Minko82/xlerobot-pro/cube-vision/outputs/ik_target.png

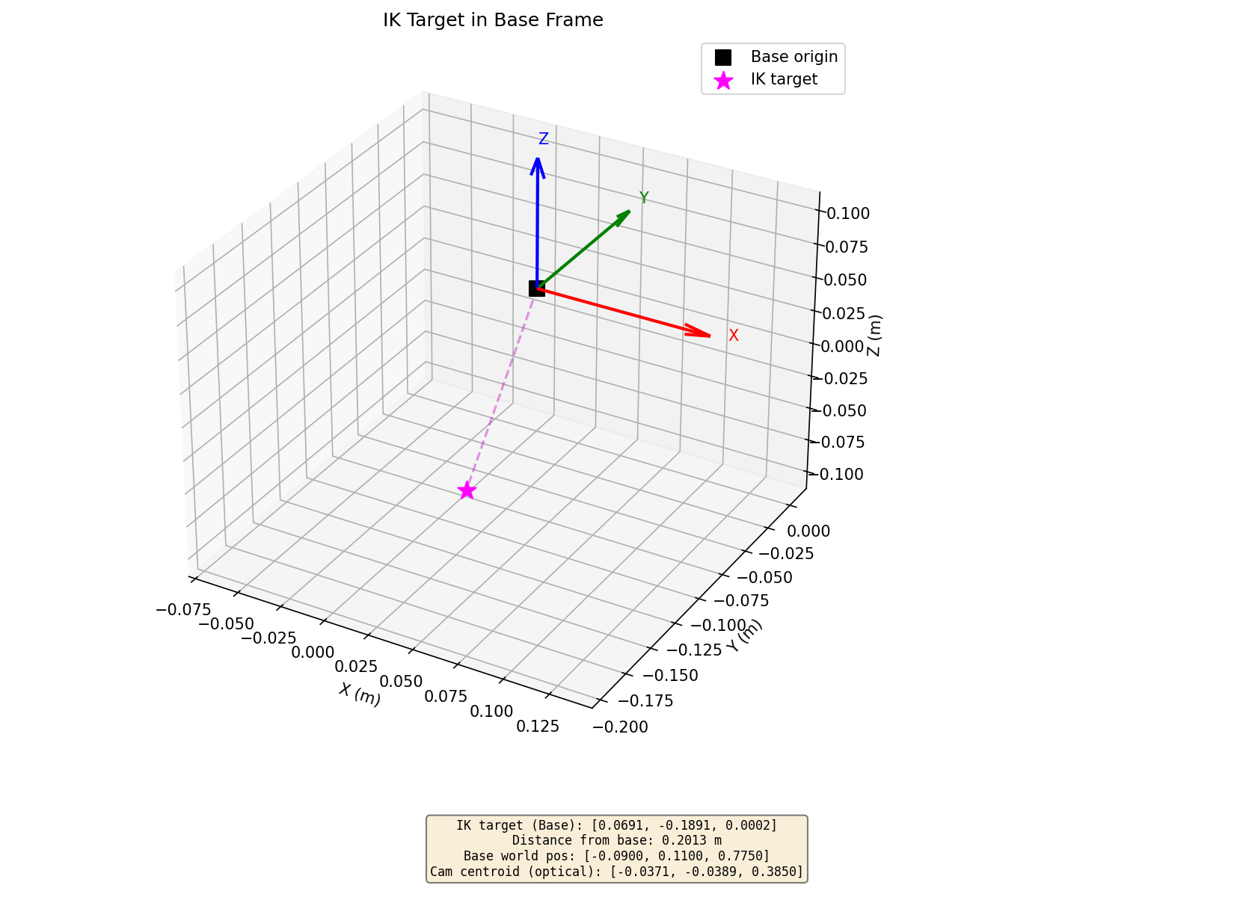
cube-vision/outputs/ik_target.png
