Minko82/xlerobot-pro/cube-vision/outputs/realsense_capture/color.png

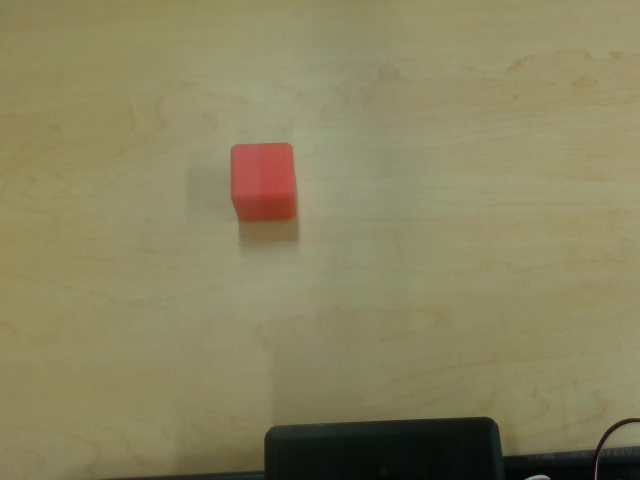
cube-vision/outputs/realsense_capture/color.png
