Minko82/xlerobot-pro/cube-vision/outputs/realsense_capture/color_detect_vis.png

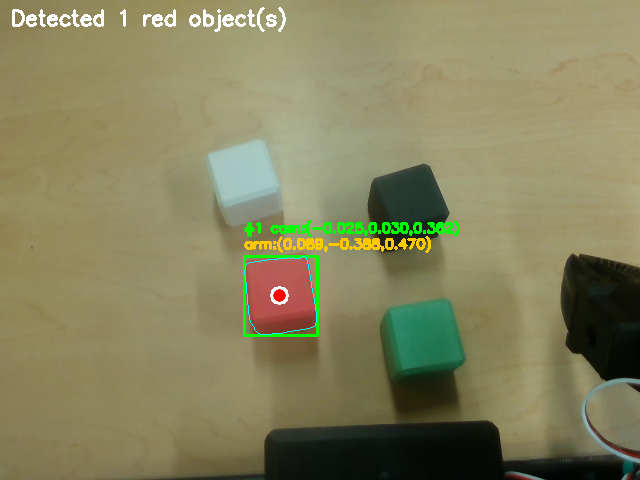
cube-vision/outputs/realsense_capture/color_detect_vis.png
