Minko82/xlerobot-pro/cube-vision/outputs/realsense_capture/depth_16u.png

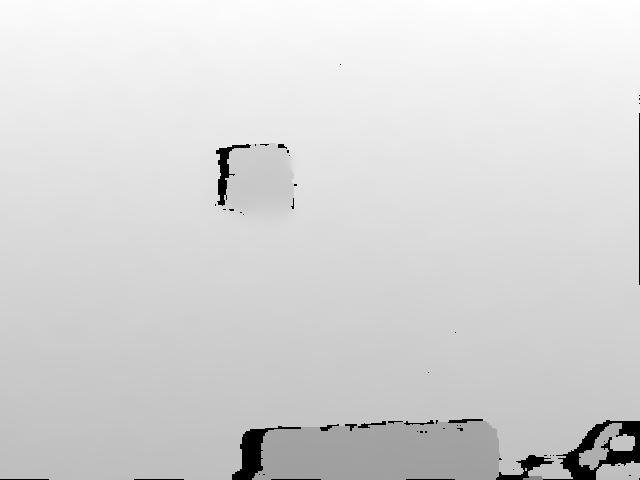
cube-vision/outputs/realsense_capture/depth_16u.png
