Minko82/xlerobot-pro/cube-vision/pincer_transform/outputs/realsense_capture/color.png

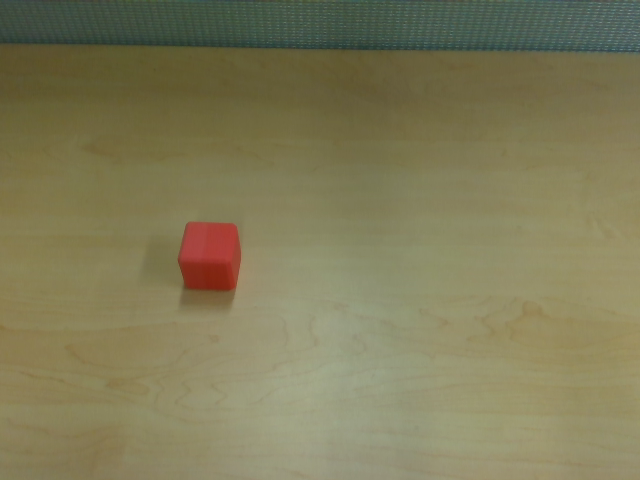
cube-vision/pincer_transform/outputs/realsense_capture/color.png
