Minko82/xlerobot-pro/cube-vision/pincer_transform/outputs/realsense_capture/depth_16u.png

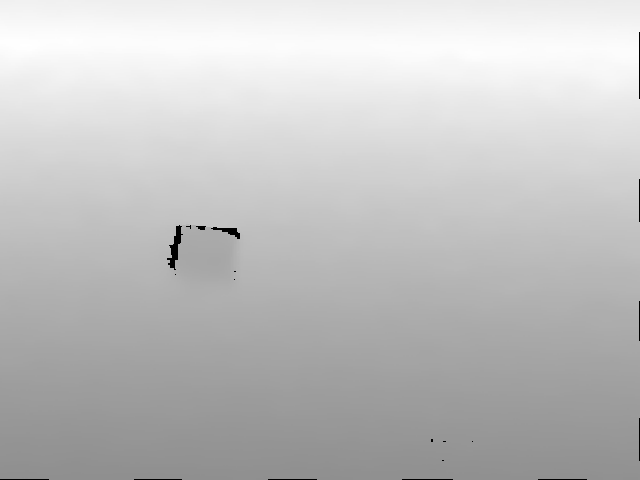
cube-vision/pincer_transform/outputs/realsense_capture/depth_16u.png
