Minko82/xlerobot-pro/hardware/XLeRobot-Pro.3mf

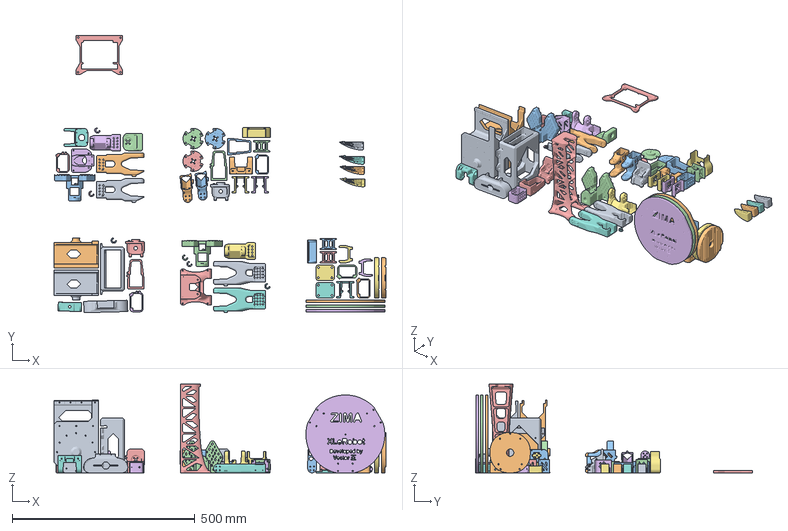
[picture p8: CAD file, 2026-10-27]
hardware/XLeRobot-Pro.3mf
908.2 x 758.7 x 242.5 mm
XLeRobot_0_3_0_1
XLeRobot_0_3_0_2 x 2
XLeRobot_0_3_0_3
XLeRobot_0_3_0_4
XLeRobot_0_3_0_5
XLeRobot_0_3_0_7
XLeRobot_0_3_0_9
XLeRobot_0_3_0_10
XLeRobot_0_3_0_11
XLeRobot_0_3_0_12
XLeRobot_0_3_0_13
XLeRobot_0_3_0_16
XLeRobot_0_3_0_17
XLeRobot_0_3_0_18
XLeRobot_0_3_0_20
XLeRobot_0_3_0_21
XLeRobot_0_3_0_24
XLeRobot_0_3_0_25
XLeRobot_0_3_0_30
XLeRobot_0_3_0_31
XLeRobot_0_3_0_32
XLeRobot_0_3_0_33
XLeRobot_0_3_0_34
XLeRobot_0_3_0_35
XLeRobot_0_3_0_36
XLeRobot_0_3_0_37 (arm, High-Shell) x 2
XLeRobot_0_3_0_38 (arm, High-Shell) x 2
XLeRobot_0_3_0_39 (arm, High-Shell) x 2
XLeRobot_0_3_0_40 (arm, High-Shell) x 2
XLeRobot_0_3_0_41 (arm, High-Shell) x 2
XLeRobot_0_3_0_42 (arm, High-Shell) x 2
XLeRobot_0_3_0_43 (arm, High-Shell) x 2
XLeRobot_0_3_0_44 (arm, High-Shell) x 2
XLeRobot_0_3_0_45 (arm, High-Shell) x 2
XLeRobot_0_3_0_46
XLeRobot_0_3_0_47
XLeRobot_0_3_0_48
XLeRobot_0_3_0_49
XLeRobot_0_3_0_50
XLeRobot_0_3_0_51
Jetson open frame
