Minko82/xlerobot-pro/hardware/XLeRobot040_armbase.step

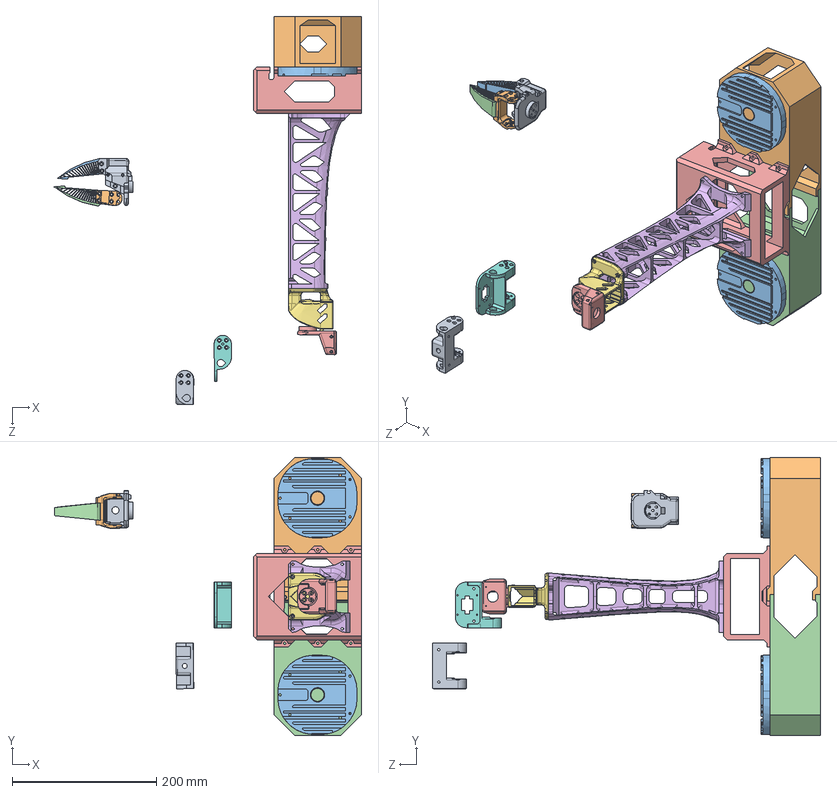
[picture p9: CAD file, 2026-10-11]
hardware/XLeRobot040_armbase.step
426.9 x 386.3 x 538.7 mm
035hand.step
soft_gripper_finger.step
Gimbal_Yaw.step
XLeRobot 0-2-9-3d.step
Gimbal_Base.step
Folder 136
035armbase.step
XLeRobot 0-2-9bas.step
