Minko82/xlerobot-pro/hardware/nvidia-jetson-mounting-frame.stl

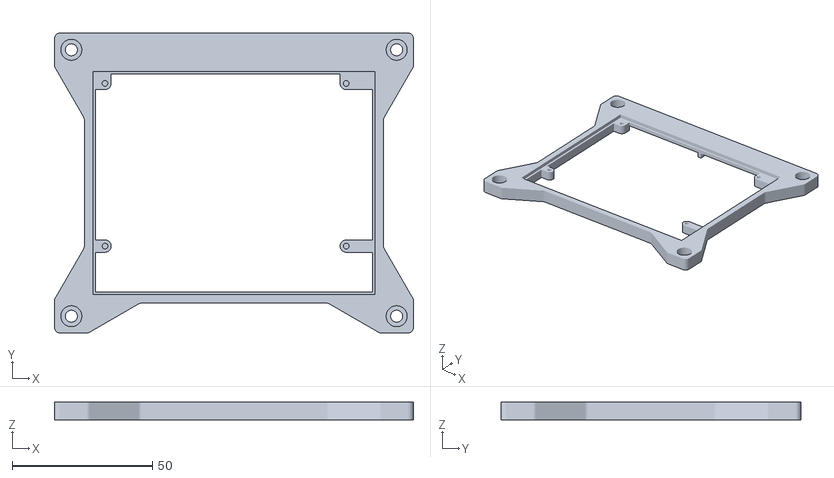
[picture p10: CAD file, 2026-10-11]
hardware/nvidia-jetson-mounting-frame.stl
128.0 x 107.0 x 6.30
