Minko82/xlerobot-pro/(list of files, cad)

Other CAD files:
cube-vision/example_capture/outputs/realsense_capture/vision.ply
