Minko82/xlerobot-pro/examples/precision_test_results.csv

trial | start_x | start_y | start_z | start_pan | target_x | target_y | target_z | target_pan | final_x | final_y | final_z | final_pan | x_error_mm | y_error_mm | z_error_mm | euclidean_error_mm | pan_error_deg
1 | 0.179924 | 0.059685 | 0.000000 | -36.844 | 0.162900 | 0.113100 | 0.000000 | 0.000 | -0.097528 | 0.145064 | 0.000000 | -33.820 | -260.4283 | 31.9638 | 0.0000 | 262.3825 | -33.8195
2 | 0.133913 | 0.084498 | 0.000000 | -37.503 | 0.162900 | 0.113100 | 0.000000 | 0.000 | -0.122219 | 0.116722 | 0.000000 | -34.282 | -285.1193 | 3.6219 | 0.0000 | 285.1423 | -34.2822
3 | 0.173668 | 0.139240 | 0.000000 | 39.840 | 0.162900 | 0.113100 | 0.000000 | 0.000 | -0.096881 | 0.170610 | 0.000000 | -26.995 | -259.7806 | 57.5102 | 0.0000 | 266.0702 | -26.9948
4 | 0.176573 | 0.100096 | 0.000000 | -38.066 | 0.162900 | 0.113100 | 0.000000 | 0.000 | -0.095513 | 0.170905 | 0.000000 | -34.398 | -258.4129 | 57.8045 | 0.0000 | 264.7991 | -34.3979
5 | 0.133247 | 0.110077 | 0.000000 | -21.797 | 0.162900 | 0.113100 | 0.000000 | 0.000 | -0.123035 | 0.114905 | 0.000000 | -34.398 | -285.9349 | 1.8046 | 0.0000 | 285.9406 | -34.3979
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
