Minko82/xlerobot-pro/src/lerobot/robots/xlerobot_2wheels/xlerobot_2wheels_client.py

# Copyright 2024 The HuggingFace Inc. team. All rights reserved.
#
# Licensed under the Apache License, Version 2.0 (the "License");
# you may not use this file except in compliance with the License.
# You may obtain a copy of the License at
#
#     http://www.apache.org/licenses/LICENSE-2.0
#
# Unless required by applicable law or agreed to in writing, software
# distributed under the License is distributed on an "AS IS" BASIS,
# WITHOUT WARRANTIES OR CONDITIONS OF ANY KIND, either express or implied.
# See the License for the specific language governing permissions and
# limitations under the License.

# TODO(aliberts, Steven, Pepijn): use gRPC calls instead of zmq?

import base64
import json
import logging
from functools import cached_property
from typing import Any, Dict, Optional, Tuple

import cv2
import numpy as np
import zmq

from lerobot.utils.errors import DeviceAlreadyConnectedError, DeviceNotConnectedError

from ..robot import Robot
from .config_xlerobot_2wheels import XLerobot2WheelsConfig, XLerobot2WheelsClientConfig


class XLerobot2WheelsClient(Robot):
    config_class = XLerobot2WheelsClientConfig
    name = "xlerobot_2wheels_client"

    def __init__(self, config: XLerobot2WheelsClientConfig):
        super().__init__(config)
        self.config = config
        self.id = config.id
        self.robot_type = config.type

        self.remote_ip = config.remote_ip
        self.port_zmq_cmd = config.port_zmq_cmd
        self.port_zmq_observations = config.port_zmq_observations

        self.teleop_keys = config.teleop_keys

        self.polling_timeout_ms = config.polling_timeout_ms
        self.connect_timeout_s = config.connect_timeout_s

        self.zmq_context = None
        self.zmq_cmd_socket = None
        self.zmq_observation_socket = None

        self.last_frames = {}
        self.last_remote_state = {}

        # Define three speed levels and a current index
        self.speed_levels = [
            {"linear": 0.1, "angular": 30},  # slow
            {"linear": 0.2, "angular": 60},  # medium
            {"linear": 0.3, "angular": 90},  # fast
        ]
        self.speed_index = 0  # Start at slow

        self._is_connected = False
        self.logs = {}

    @cached_property
    def _state_ft(self) -> dict[str, type]:
        return dict.fromkeys(
            (
                "left_arm_shoulder_pan.pos",
                "left_arm_shoulder_lift.pos",
                "left_arm_elbow_flex.pos",
                "left_arm_wrist_flex.pos",
                "left_arm_wrist_roll.pos",
                "left_arm_gripper.pos",
                "right_arm_shoulder_pan.pos",
                "right_arm_shoulder_lift.pos",
                "right_arm_elbow_flex.pos",
                "right_arm_wrist_flex.pos",
                "right_arm_wrist_roll.pos",
                "right_arm_gripper.pos",
                "head_motor_1.pos",
                "head_motor_2.pos",
                "x.vel",
                "theta.vel",  # Only x and theta for differential drive
            ),
            float,
        )
        
    @cached_property
    def _state_order(self) -> tuple[str, ...]:
        return tuple(self._state_ft.keys())

    @cached_property
    def _cameras_ft(self) -> dict[str, tuple[int, int, int]]:
        return {name: (cfg.height, cfg.width, 3) for name, cfg in self.config.cameras.items()}

    @cached_property
    def observation_features(self) -> dict[str, type | tuple]:
        return {**self._state_ft, **self._cameras_ft}

    @cached_property
    def action_features(self) -> dict[str, type]:
        return self._state_ft

    @property
    def is_connected(self) -> bool:
        return self._is_connected

    @property
    def is_calibrated(self) -> bool:
        pass

    def connect(self) -> None:
        """Establishes ZMQ sockets with the remote mobile robot"""

        if self._is_connected:
            raise DeviceAlreadyConnectedError(
                "XLerobot2Wheels Daemon is already connected. Do not run `robot.connect()` twice."
            )

        self.zmq_context = zmq.Context()
        self.zmq_cmd_socket = self.zmq_context.socket(zmq.PUSH)
        zmq_cmd_locator = f"tcp://{self.remote_ip}:{self.port_zmq_cmd}"
        self.zmq_cmd_socket.connect(zmq_cmd_locator)
        self.zmq_cmd_socket.setsockopt(zmq.CONFLATE, 1)

        self.zmq_observation_socket = self.zmq_context.socket(zmq.PULL)
        zmq_observations_locator = f"tcp://{self.remote_ip}:{self.port_zmq_observations}"
        self.zmq_observation_socket.connect(zmq_observations_locator)
        self.zmq_observation_socket.setsockopt(zmq.CONFLATE, 1)

        poller = zmq.Poller()
        poller.register(self.zmq_observation_socket, zmq.POLLIN)
        socks = dict(poller.poll(self.connect_timeout_s * 1000))
        if self.zmq_observation_socket not in socks or socks[self.zmq_observation_socket] != zmq.POLLIN:
            raise DeviceNotConnectedError("Timeout waiting for XLerobot2Wheels Host to connect expired.")

        self._is_connected = True

    def calibrate(self) -> None:
        pass

    def _poll_and_get_latest_message(self) -> Optional[str]:
        """Polls the ZMQ socket for a limited time and returns the latest message string."""
        poller = zmq.Poller()
        poller.register(self.zmq_observation_socket, zmq.POLLIN)

        try:
            socks = dict(poller.poll(self.polling_timeout_ms))
        except zmq.ZMQError as e:
            logging.error(f"ZMQ polling error: {e}")
            return None

        if self.zmq_observation_socket not in socks:
            logging.info("No new data available within timeout.")
            return None

        last_msg = None
        while True:
            try:
                msg = self.zmq_observation_socket.recv_string(zmq.NOBLOCK)
                last_msg = msg
            except zmq.Again:
                break

        if last_msg is None:
            logging.warning("Poller indicated data, but failed to retrieve message.")

        return last_msg

    def _parse_observation_json(self, obs_string: str) -> Optional[Dict[str, Any]]:
        """Parses the JSON observation string."""
        try:
            return json.loads(obs_string)
        except json.JSONDecodeError as e:
            logging.error(f"Error decoding JSON observation: {e}")
            return None

    def _decode_image_from_b64(self, image_b64: str) -> Optional[np.ndarray]:
        """Decodes a base64 encoded image string to an OpenCV image."""
        if not image_b64:
            return None
        try:
            jpg_data = base64.b64decode(image_b64)
            np_arr = np.frombuffer(jpg_data, dtype=np.uint8)
            frame = cv2.imdecode(np_arr, cv2.IMREAD_COLOR)
            if frame is None:
                logging.warning("cv2.imdecode returned None for an image.")
            return frame
        except (TypeError, ValueError) as e:
            logging.error(f"Error decoding base64 image data: {e}")
            return None

    def _remote_state_from_obs(
        self, observation: Dict[str, Any]
    ) -> Tuple[Dict[str, np.ndarray], Dict[str, Any]]:
        """Extracts frames, and state from the parsed observation."""

        flat_state = {key: observation.get(key, 0.0) for key in self._state_order}

        state_vec = np.array([flat_state[key] for key in self._state_order], dtype=np.float32)

        obs_dict: Dict[str, Any] = {**flat_state, "observation.state": state_vec}

        # Decode images
        current_frames: Dict[str, np.ndarray] = {}
        for cam_name, image_b64 in observation.items():
            if cam_name not in self._cameras_ft:
                continue
            frame = self._decode_image_from_b64(image_b64)
            if frame is not None:
                current_frames[cam_name] = frame

        return current_frames, obs_dict

    def _get_data(self) -> Tuple[Dict[str, np.ndarray], Dict[str, Any], Dict[str, Any]]:
        """
        Polls the video socket for the latest observation data.

        Attempts to retrieve and decode the latest message within a short timeout.
        If successful, updates and returns the new frames, speed, and arm state.
        If no new data arrives or decoding fails, returns the last known values.
        """

        # 1. Get the latest message string from the socket
        latest_message_str = self._poll_and_get_latest_message()

        # 2. If no message, return cached data
        if latest_message_str is None:
            return self.last_frames, self.last_remote_state

        # 3. Parse the JSON message
        observation = self._parse_observation_json(latest_message_str)

        # 4. If JSON parsing failed, return cached data
        if observation is None:
            return self.last_frames, self.last_remote_state

        # 5. Process the valid observation data
        try:
            new_frames, new_state = self._remote_state_from_obs(observation)
        except Exception as e:
            logging.error(f"Error processing observation data, serving last observation: {e}")
            return self.last_frames, self.last_remote_state

        self.last_frames = new_frames
        self.last_remote_state = new_state

        return new_frames, new_state

    def get_observation(self) -> dict[str, Any]:
        """
        Capture observations from the remote robot: current follower arm positions,
        present wheel speeds (converted to body-frame velocities: x, theta),
        and a camera frame. Receives over ZMQ, translate to body-frame vel
        """
        if not self._is_connected:
            raise DeviceNotConnectedError("XLerobot2WheelsClient is not connected. You need to run `robot.connect()`.")

        frames, obs_dict = self._get_data()

        # Loop over each configured camera
        for cam_name, frame in frames.items():
            if frame is None:
                logging.warning("Frame is None")
                frame = np.zeros((640, 480, 3), dtype=np.uint8)
            obs_dict[cam_name] = frame

        return obs_dict

    def _from_keyboard_to_base_action(self, pressed_keys: np.ndarray):
        # Speed control
        if self.teleop_keys["speed_up"] in pressed_keys:
            self.speed_index = min(self.speed_index + 1, 2)
        if self.teleop_keys["speed_down"] in pressed_keys:
            self.speed_index = max(self.speed_index - 1, 0)
        speed_setting = self.speed_levels[self.speed_index]
        linear_speed = speed_setting["linear"]  # e.g. 0.1, 0.2, or 0.3
        angular_speed = speed_setting["angular"]  # e.g. 30, 60, or 90

        x_cmd = 0.0  # m/s forward/backward
        theta_cmd = 0.0  # deg/s rotation

        if self.teleop_keys["forward"] in pressed_keys:
            x_cmd += linear_speed
        if self.teleop_keys["backward"] in pressed_keys:
            x_cmd -= linear_speed
        if self.teleop_keys["rotate_left"] in pressed_keys:
            theta_cmd += angular_speed
        if self.teleop_keys["rotate_right"] in pressed_keys:
            theta_cmd -= angular_speed
            
        return {
            "x.vel": x_cmd, 
            "theta.vel": theta_cmd,
        }

    def configure(self):
        pass

    def send_action(self, action: dict[str, Any]) -> dict[str, Any]:
        """Command xlerobot_2wheels to move to a target joint configuration. Translates to motor space + sends over ZMQ

        Args:
            action (np.ndarray): array containing the goal positions for the motors.

        Raises:
            RobotDeviceNotConnectedError: if robot is not connected.

        Returns:
            np.ndarray: the action sent to the motors, potentially clipped.
        """
        if not self._is_connected:
            raise DeviceNotConnectedError(
                "XLerobot2Wheels is not connected. You need to run `robot.connect()`."
            )

        self.zmq_cmd_socket.send_string(json.dumps(action))  # action is in motor space

        # TODO(Steven): Remove the np conversion when it is possible to record a non-numpy array value
        actions = np.array([action.get(k, 0.0) for k in self._state_order], dtype=np.float32)

        action_sent = {key: actions[i] for i, key in enumerate(self._state_order)}
        action_sent["action"] = actions
        return action_sent

    def disconnect(self):
        """Cleans ZMQ comms"""

        if not self._is_connected:
            raise DeviceNotConnectedError(
                "XLerobot2Wheels is not connected. You need to run `robot.connect()` before disconnecting."
            )
        self.zmq_observation_socket.close()
        self.zmq_cmd_socket.close()
        self.zmq_context.term()
        self._is_connected = False
