Minko82/xlerobot-pro/src/lerobot/robots/xlerobot/config_xlerobot.py

# Copyright 2024 The HuggingFace Inc. team. All rights reserved.
#
# Licensed under the Apache License, Version 2.0 (the "License");
# you may not use this file except in compliance with the License.
# You may obtain a copy of the License at
#
#     http://www.apache.org/licenses/LICENSE-2.0
#
# Unless required by applicable law or agreed to in writing, software
# distributed under the License is distributed on an "AS IS" BASIS,
# WITHOUT WARRANTIES OR CONDITIONS OF ANY KIND, either express or implied.
# See the License for the specific language governing permissions and
# limitations under the License.

from dataclasses import dataclass, field

from lerobot.cameras.configs import CameraConfig, Cv2Rotation, ColorMode
from lerobot.cameras.opencv.configuration_opencv import OpenCVCameraConfig
from lerobot.cameras.realsense import RealSenseCamera, RealSenseCameraConfig

from ..config import RobotConfig


def xlerobot_cameras_config() -> dict[str, CameraConfig]:
    return {
        # "left_wrist": OpenCVCameraConfig(
        #     index_or_path="/dev/video0", fps=30, width=640, height=480, rotation=Cv2Rotation.NO_ROTATION
        # ),

        # "right_wrist": OpenCVCameraConfig(
        #     index_or_path="/dev/video2", fps=30, width=640, height=480, rotation=Cv2Rotation.NO_ROTATION
        # ),  

        # "head(RGDB)": OpenCVCameraConfig(
        #     index_or_path="/dev/video2", fps=30, width=640, height=480, rotation=Cv2Rotation.NO_ROTATION
        # ),                     
        
        # "head": RealSenseCameraConfig(
        #     serial_number_or_name="125322060037",  # Replace with camera SN
        #     fps=30,
        #     width=1280,
        #     height=720,
        #     color_mode=ColorMode.BGR, # Request BGR output
        #     rotation=Cv2Rotation.NO_ROTATION,
        #     use_depth=True
        # ),
    }


@RobotConfig.register_subclass("xlerobot")
@dataclass
class XLerobotConfig(RobotConfig):
    """
    OLD WIRING DESIGN
    Bus 1 (port1): Motors 1-6 = left arm, Motors 7-8 = head
    Bus 2 (port2): Motors 1-6 = right arm, Motors 7-9 = base wheels
    """

    port1: str = "/dev/xle_right"  # Bus 1: left arm (1-6) + head (7-8)
    port2: str = "/dev/xle_left"   # Bus 2: right arm (1-6) + base wheels (7-9)
    disable_torque_on_disconnect: bool = True

    # `max_relative_target` limits the magnitude of the relative positional target vector for safety purposes.
    # Set this to a positive scalar to have the same value for all motors, or a list that is the same length as
    # the number of motors in your follower arms.
    max_relative_target: int | None = None

    cameras: dict[str, CameraConfig] = field(default_factory=xlerobot_cameras_config)

    # Set to `True` for backward compatibility with previous policies/dataset
    use_degrees: bool = False

    teleop_keys: dict[str, str] = field(
        default_factory=lambda: {
            # Movement
            "forward": "i",
            "backward": "k",
            "left": "j",
            "right": "l",
            "rotate_left": "u",
            "rotate_right": "o",
            # Speed control
            "speed_up": "n",
            "speed_down": "m",
            # quit teleop
            "quit": "b",
        }
    )



@dataclass
class XLerobotHostConfig:
    # Network Configuration
    port_zmq_cmd: int = 5555
    port_zmq_observations: int = 5556

    # Duration of the application
    connection_time_s: int = 3600

    # Watchdog: stop the robot if no command is received for over 0.5 seconds.
    watchdog_timeout_ms: int = 500

    # If robot jitters decrease the frequency and monitor cpu load with `top` in cmd
    max_loop_freq_hz: int = 30

@RobotConfig.register_subclass("xlerobot_client")
@dataclass
class XLerobotClientConfig(RobotConfig):
    # Network Configuration
    remote_ip: str
    port_zmq_cmd: int = 5555
    port_zmq_observations: int = 5556

    teleop_keys: dict[str, str] = field(
        default_factory=lambda: {
            # Movement
            "forward": "i",
            "backward": "k",
            "left": "j",
            "right": "l",
            "rotate_left": "u",
            "rotate_right": "o",
            # Speed control
            "speed_up": "n",
            "speed_down": "m",
            # quit teleop
            "quit": "b",
        }
    )

    cameras: dict[str, CameraConfig] = field(default_factory=xlerobot_cameras_config)

    polling_timeout_ms: int = 15
    connect_timeout_s: int = 5


@RobotConfig.register_subclass("xlerobot_new_wiring")
@dataclass
class XLerobotNewWiringConfig(RobotConfig):
    """
    NEW WIRING DESIGN
    Bus 1 (port1): Motors 1-6 = left arm, Motors 7-12 = right arm
    Bus 2 (port2): Motors 1-2 = head, Motors 3-5 = base wheels
    """

    port1: str = "/dev/xle_arms"   # Bus 1: left arm (1-6) + right arm (7-12)
    port2: str = "/dev/xle_head"   # Bus 2: head (1-2) + base wheels (3-5)
    disable_torque_on_disconnect: bool = True

    max_relative_target: int | None = None

    cameras: dict[str, CameraConfig] = field(default_factory=xlerobot_cameras_config)

    use_degrees: bool = False

    teleop_keys: dict[str, str] = field(
        default_factory=lambda: {
            # Movement
            "forward": "i",
            "backward": "k",
            "left": "j",
            "right": "l",
            "rotate_left": "u",
            "rotate_right": "o",
            # Speed control
            "speed_up": "n",
            "speed_down": "m",
            # quit teleop
            "quit": "b",
        }
    )
