Minko82/xlerobot-pro/src/lerobot/teleoperators/xlerobot_vr/vr_monitor.py

#!/usr/bin/env python3
"""
VR Monitor - Independent VR control information monitoring script
Can call XLeVR's VR functionality from other folders and read/print VR control information
"""

import asyncio
import contextlib
import http.server
import os
import socket
import ssl
import sys
import threading

# Set the absolute path to the xlevr folder
XLEVR_PATH = "/home/cics/Desktop/codes/projects/XLeRobot/XLeVR"


def setup_xlevr_environment():
    """Setup xlevr environment"""
    # Add xlevr path to Python path
    if XLEVR_PATH not in sys.path:
        sys.path.insert(0, XLEVR_PATH)

    # Set working directory
    os.chdir(XLEVR_PATH)

    # Set environment variables
    os.environ["PYTHONPATH"] = f"{XLEVR_PATH}:{os.environ.get('PYTHONPATH', '')}"


def get_local_ip():
    """Get the local IP address of this machine."""
    try:
        # Connect to a remote address to determine the local IP
        with socket.socket(socket.AF_INET, socket.SOCK_DGRAM) as s:
            s.connect(("8.8.8.8", 80))
            return s.getsockname()[0]
    except Exception:
        try:
            # Fallback: get hostname IP
            return socket.gethostbyname(socket.gethostname())
        except Exception:
            # Final fallback
            return "localhost"


def import_xlevr_modules():
    """Import xlevr modules"""
    try:
        from xlevr.config import XLeVRConfig
        from xlevr.inputs.base import ControlGoal, ControlMode
        from xlevr.inputs.vr_ws_server import VRWebSocketServer

        return XLeVRConfig, VRWebSocketServer, ControlGoal, ControlMode
    except ImportError as e:
        print(f"Error importing xlevr modules: {e}")
        print(f"Make sure XLEVR_PATH is correct: {XLEVR_PATH}")
        return None, None, None, None


class SimpleAPIHandler(http.server.BaseHTTPRequestHandler):
    """Simplified HTTP request handler, only provides basic web services"""

    def end_headers(self):
        """Add CORS headers to all responses."""
        self.send_header("Access-Control-Allow-Origin", "*")
        self.send_header("Access-Control-Allow-Methods", "GET, POST, OPTIONS")
        self.send_header("Access-Control-Allow-Headers", "Content-Type")
        with contextlib.suppress(BrokenPipeError, ConnectionResetError, ConnectionAbortedError, ssl.SSLError):
            super().end_headers()

    def do_OPTIONS(self):
        """Handle preflight CORS requests."""
        self.send_response(200)
        self.end_headers()

    def log_message(self, format, *args):
        """Override to reduce HTTP request logging noise."""
        pass  # Disable default HTTP logging

    def do_GET(self):
        """Handle GET requests."""
        if self.path == "/" or self.path == "/index.html":
            # Serve main page from web-ui directory
            self.serve_file("web-ui/index.html", "text/html")
        elif self.path.endswith(".css"):
            # Serve CSS files from web-ui directory
            self.serve_file(f"web-ui{self.path}", "text/css")
        elif self.path.endswith(".js"):
            # Serve JS files from web-ui directory
            self.serve_file(f"web-ui{self.path}", "application/javascript")
        elif self.path.endswith(".ico"):
            self.serve_file(self.path[1:], "image/x-icon")
        elif self.path.endswith((".jpg", ".jpeg", ".png", ".gif")):
            # Serve image files from web-ui directory
            content_type = (
                "image/jpeg"
                if self.path.endswith((".jpg", ".jpeg"))
                else "image/png"
                if self.path.endswith(".png")
                else "image/gif"
            )
            self.serve_file(f"web-ui{self.path}", content_type)
        else:
            self.send_error(404, "Not found")

    def serve_file(self, filename, content_type):
        """Serve a file with the given content type."""
        try:
            # Get the web root path from the server
            web_root = getattr(self.server, "web_root_path", XLEVR_PATH)
            file_path = os.path.join(web_root, filename)

            if os.path.exists(file_path):
                with open(file_path, "rb") as f:
                    content = f.read()

                self.send_response(200)
                self.send_header("Content-Type", content_type)
                self.end_headers()
                self.wfile.write(content)
            else:
                self.send_error(404, f"File not found: {filename}")
        except Exception as e:
            print(f"Error serving file {filename}: {e}")
            self.send_error(500, "Internal server error")


class SimpleHTTPSServer:
    """Simplified HTTPS server for providing web interface"""

    def __init__(self, config):
        self.config = config
        self.httpd = None
        self.server_thread = None
        self.web_root_path = XLEVR_PATH

    async def start(self):
        """Start the HTTPS server."""
        try:
            # Create server
            self.httpd = http.server.HTTPServer(
                (self.config.host_ip, self.config.https_port), SimpleAPIHandler
            )

            # Set web root path for file serving
            self.httpd.web_root_path = self.web_root_path

            # Setup SSL
            context = ssl.SSLContext(ssl.PROTOCOL_TLS_SERVER)
            context.load_cert_chain("cert.pem", "key.pem")
            self.httpd.socket = context.wrap_socket(self.httpd.socket, server_side=True)

            # Start server in a separate thread
            self.server_thread = threading.Thread(target=self.httpd.serve_forever, daemon=True)
            self.server_thread.start()

            print(f"🌐 HTTPS server started on {self.config.host_ip}:{self.config.https_port}")

        except Exception as e:
            print(f"❌ Failed to start HTTPS server: {e}")
            raise

    async def stop(self):
        """Stop the HTTPS server."""
        if self.httpd:
            self.httpd.shutdown()
            if self.server_thread:
                self.server_thread.join(timeout=5)
            print("🌐 HTTPS server stopped")


class VRMonitor:
    """VR control information monitor"""

    def __init__(self):
        self.config = None
        self.vr_server = None
        self.https_server = None
        self.is_running = False
        self.latest_goal = None  # Store the latest goal
        self.left_goal = None  # Store left and right controller goals separately
        self.right_goal = None
        self.headset_goal = None  # Add headset goal
        self._goal_lock = threading.Lock()  # Add thread lock

    def initialize(self):
        """Initialize VR monitor"""
        print("🔧 Initializing XLeVR Monitor...")

        # Setup environment
        setup_xlevr_environment()

        # Import modules
        XLeVRConfig, VRWebSocketServer, ControlGoal, ControlMode = import_xlevr_modules()  # noqa: N806
        if XLeVRConfig is None:
            print("❌ Failed to import xlevr modules")
            return False

        # Create configuration
        self.config = XLeVRConfig()
        self.config.enable_vr = True
        self.config.enable_keyboard = False
        self.config.enable_https = True  # Enable HTTPS server, VR requires web interface

        # Create command queue
        self.command_queue = asyncio.Queue()

        # Create VR server (print-only mode)
        try:
            self.vr_server = VRWebSocketServer(
                command_queue=self.command_queue,
                config=self.config,
                print_only=False,  # Changed to False to send data to queue
            )
        except Exception as e:
            print(f"❌ Failed to create VR WebSocket server: {e}")
            return False

        # Create HTTPS server
        try:
            self.https_server = SimpleHTTPSServer(self.config)
        except Exception as e:
            print(f"❌ Failed to create HTTPS server: {e}")
            return False

        print("✅ XLeVR Monitor initialized successfully")

        return True

    async def start_monitoring(self):
        """Start monitoring VR control information"""
        print("🚀 Starting VR Monitor...")

        if not self.initialize():
            print("❌ Failed to initialize VR monitor")
            return

        try:
            # Start HTTPS server
            await self.https_server.start()

            # Start VR server
            await self.vr_server.start()

            self.is_running = True
            print("✅ VR Monitor is now running")

            # Display connection information (comparing against 0.0.0.0, not binding to it)
            host_display = get_local_ip() if self.config.host_ip == "0.0.0.0" else self.config.host_ip  # nosec B104
            print("📱 Open your VR headset browser and navigate to:")
            print(f"   https://{host_display}:{self.config.https_port}")
            print("🎯 Press Ctrl+C to stop monitoring")
            print()

            # Monitor command queue
            await self.monitor_commands()

        except KeyboardInterrupt:
            print("\n⏹️  Stopping VR monitor...")
        except Exception as e:
            print(f"❌ Error in VR monitor: {e}")
            import traceback

            print(f"Traceback: {traceback.format_exc()}")
        finally:
            await self.stop_monitoring()

    async def monitor_commands(self):
        """Monitor commands from VR controllers"""
        print("📊 Monitoring VR control commands...")

        while self.is_running:
            try:
                # Wait for command with 1-second timeout
                goal = await asyncio.wait_for(self.command_queue.get(), timeout=1.0)

                # Save goal by arm type
                with self._goal_lock:
                    if goal.arm == "left":
                        self.left_goal = goal
                    elif goal.arm == "right":
                        self.right_goal = goal
                    elif goal.arm == "headset":  # Add headset data processing
                        self.headset_goal = goal

                    # Maintain backward compatibility, save latest goal
                    self.latest_goal = goal

            except asyncio.TimeoutError:
                # Timeout, continue loop
                continue
            except Exception as e:
                print(f"❌ Error processing command: {e}")
                import traceback

                print(f"Traceback: {traceback.format_exc()}")

    def print_control_goal(self, goal):
        """Print control goal information"""
        print("\n🎮 Control Goal Received:")
        print(f"   Timestamp: {asyncio.get_event_loop().time():.3f}")
        print(f"   Arm: {goal.arm}")
        print(f"   Mode: {goal.mode}")

        if goal.target_position is not None:
            if isinstance(goal.target_position, (list, tuple)):
                pos = goal.target_position
                print(f"   Target Position: [{pos[0]:.3f}, {pos[1]:.3f}, {pos[2]:.3f}]")
            else:
                print(f"   Target Position: {goal.target_position}")

        if goal.wrist_roll_deg is not None:
            print(f"   Wrist Roll: {goal.wrist_roll_deg:.1f}°")

        if goal.wrist_flex_deg is not None:
            print(f"   Wrist Flex: {goal.wrist_flex_deg:.1f}°")

        if goal.gripper_closed is not None:
            print(f"   Gripper: {'CLOSED' if goal.gripper_closed else 'OPEN'}")

        if goal.metadata:
            print(f"   Metadata: {goal.metadata}")

        print("-" * 30)

    def get_latest_goal_nowait(self, arm=None):
        """Return the latest VR control goal if available, else None.

        Args:
            arm: If specified ("left" or "right"), return that arm's goal.
                 If None, return a dict containing both left and right goals.
        """
        with self._goal_lock:
            if arm == "left":
                return self.left_goal
            elif arm == "right":
                return self.right_goal
            elif arm == "headset":  # Add headset data retrieval
                return self.headset_goal
            else:
                # Return dictionary containing both left and right controllers
                dual_goals = {
                    "left": self.left_goal,
                    "right": self.right_goal,
                    "headset": self.headset_goal,  # Add headset data
                    "has_left": self.left_goal is not None,
                    "has_right": self.right_goal is not None,
                    "has_headset": self.headset_goal is not None,  # Add headset status
                }

                return dual_goals

    def get_left_goal_nowait(self):
        """Return the latest left arm goal if available, else None."""
        return self.get_latest_goal_nowait("left")

    def get_right_goal_nowait(self):
        """Return the latest right arm goal if available, else None."""
        return self.get_latest_goal_nowait("right")

    async def stop_monitoring(self):
        """Stop monitoring"""
        self.is_running = False

        if self.vr_server:
            await self.vr_server.stop()

        if self.https_server:
            await self.https_server.stop()

        print("✅ VR Monitor stopped")


def main():
    """Main function"""
    print("🎮 XLeVR Monitor - XLeVR VR Control Information Monitor")
    print("=" * 60)

    # Check XLeVR path
    if not os.path.exists(XLEVR_PATH):
        print(f"❌ XLeVR path does not exist: {XLEVR_PATH}")
        print("Please update XLEVR_PATH in the script")
        return

    # Create monitor
    monitor = VRMonitor()

    # Run monitoring
    try:
        asyncio.run(monitor.start_monitoring())
    except KeyboardInterrupt:
        print("\n👋 XLeVR Monitor stopped by user")
    except Exception as e:
        print(f"❌ Unexpected error: {e}")


if __name__ == "__main__":
    main()
