Minko82/xlerobot-pro/examples/5_xlerobot_teleop_xbox_new_wiring.py

# =============================================================================
# NEW WIRING DESIGN
# Bus 1 (port1 = /dev/xle_arms): Motors 1-6 = left arm, Motors 7-12 = right arm
# Bus 2 (port2 = /dev/xle_head): Motors 1-2 = head, Motors 3-5 = base wheels
# =============================================================================

# To Run the teleop:
'''
python examples/5_xlerobot_teleop_xbox_new_wiring.py
'''

import sys
import os
# Ensure xle-robot/src is first on the path so the local lerobot package is used
sys.path.insert(0, os.path.join(os.path.dirname(os.path.abspath(__file__)), '..', 'src'))

import time
import numpy as np
import math
import pygame

from lerobot.robots.xlerobot import XLerobotNewWiringConfig
from lerobot.robots.xlerobot.xlerobot_new_wiring import XLerobotNewWiring
from lerobot.utils.visualization_utils import init_rerun, log_rerun_data
from lerobot.model.SO101Robot import SO101Kinematics

# Keymaps (semantic action: controller mapping) - Intuitive human control
LEFT_KEYMAP = {
    # Left stick controls left arm XY (when not pressed)
    'x+': 'left_stick_up', 'x-': 'left_stick_down',
    'y+': 'left_stick_right', 'y-': 'left_stick_left',
    # Left stick pressed controls left arm shoulder_pan
    'shoulder_pan+': 'left_stick_pressed_right', 'shoulder_pan-': 'left_stick_pressed_left',
    # LB pressed controls left arm pitch and wrist_roll
    'pitch+': 'lb_up', 'pitch-': 'lb_down',
    'wrist_roll+': 'lb_right', 'wrist_roll-': 'lb_left',
    # Left trigger controls left gripper
    'gripper+': 'left_trigger',
    # Head motors
    "head_motor_1+": 'x', "head_motor_1-": 'b',
    "head_motor_2+": 'a', "head_motor_2-": 'y',
}
RIGHT_KEYMAP = {
    # Right stick controls right arm XY (when not pressed)
    'x+': 'right_stick_up', 'x-': 'right_stick_down',
    'y+': 'right_stick_right', 'y-': 'right_stick_left',
    # Right stick pressed controls right arm shoulder_pan
    'shoulder_pan+': 'right_stick_pressed_right', 'shoulder_pan-': 'right_stick_pressed_left',
    # RB pressed controls right arm pitch and wrist_roll
    'pitch+': 'rb_up', 'pitch-': 'rb_down',
    'wrist_roll+': 'rb_right', 'wrist_roll-': 'rb_left',
    # Right trigger controls right gripper
    'gripper+': 'right_trigger',
}

# Base control keymap - Only forward/backward and rotate left/right
BASE_KEYMAP = {
    'forward': 'dpad_down', 'backward': 'dpad_up',
    'rotate_left': 'dpad_left', 'rotate_right': 'dpad_right',
}

# Global reset key for all components
RESET_KEY = 'back'

LEFT_JOINT_MAP = {
    "shoulder_pan": "left_arm_shoulder_pan",
    "shoulder_lift": "left_arm_shoulder_lift",
    "elbow_flex": "left_arm_elbow_flex",
    "wrist_flex": "left_arm_wrist_flex",
    "wrist_roll": "left_arm_wrist_roll",
    "gripper": "left_arm_gripper",
}
RIGHT_JOINT_MAP = {
    "shoulder_pan": "right_arm_shoulder_pan",
    "shoulder_lift": "right_arm_shoulder_lift",
    "elbow_flex": "right_arm_elbow_flex",
    "wrist_flex": "right_arm_wrist_flex",
    "wrist_roll": "right_arm_wrist_roll",
    "gripper": "right_arm_gripper",
}

HEAD_MOTOR_MAP = {
    "head_motor_1": "head_motor_1",
    "head_motor_2": "head_motor_2",
}

class SimpleHeadControl:
    def __init__(self, initial_obs, kp=1):
        self.kp = kp
        self.degree_step = 1
        # Initialize head motor positions
        self.target_positions = {
            "head_motor_1": initial_obs.get("head_motor_1.pos", 0.0),
            "head_motor_2": initial_obs.get("head_motor_2.pos", 0.0),
        }
        self.zero_pos = {"head_motor_1": 0.0, "head_motor_2": 0.0}

    def move_to_initial_position(self, robot, initial_obs):
        print("[HEAD] Moving to Initial Position for safe exit...")
        self.target_positions = {
            "head_motor_1": initial_obs.get("head_motor_1.pos", 0.0),
            "head_motor_2": initial_obs.get("head_motor_2.pos", 0.0),
        }
        action = self.p_control_action(robot)
        robot.send_action(action)

    def move_to_zero_position(self, robot):
        self.target_positions = self.zero_pos.copy()
        action = self.p_control_action(robot)
        robot.send_action(action)

    def handle_keys(self, key_state):
        if key_state.get('head_motor_1+'):
            self.target_positions["head_motor_1"] += self.degree_step
            print(f"[HEAD] head_motor_1: {self.target_positions['head_motor_1']}")
        if key_state.get('head_motor_1-'):
            self.target_positions["head_motor_1"] -= self.degree_step
            print(f"[HEAD] head_motor_1: {self.target_positions['head_motor_1']}")
        if key_state.get('head_motor_2+'):
            self.target_positions["head_motor_2"] += self.degree_step
            print(f"[HEAD] head_motor_2: {self.target_positions['head_motor_2']}")
        if key_state.get('head_motor_2-'):
            self.target_positions["head_motor_2"] -= self.degree_step
            print(f"[HEAD] head_motor_2: {self.target_positions['head_motor_2']}")

    def p_control_action(self, robot):
        obs = robot.get_observation()
        action = {}
        for motor in self.target_positions:
            current = obs.get(f"{HEAD_MOTOR_MAP[motor]}.pos", 0.0)
            error = self.target_positions[motor] - current
            control = self.kp * error
            action[f"{HEAD_MOTOR_MAP[motor]}.pos"] = current + control
        return action

class SimpleTeleopArm:
    def __init__(self, kinematics, joint_map, initial_obs, prefix="left", kp=1):
        self.kinematics = kinematics
        self.joint_map = joint_map
        self.prefix = prefix  # To distinguish left and right arm
        self.kp = kp
        # Initial joint positions
        self.joint_positions = {
            "shoulder_pan": initial_obs[f"{prefix}_arm_shoulder_pan.pos"],
            "shoulder_lift": initial_obs[f"{prefix}_arm_shoulder_lift.pos"],
            "elbow_flex": initial_obs[f"{prefix}_arm_elbow_flex.pos"],
            "wrist_flex": initial_obs[f"{prefix}_arm_wrist_flex.pos"],
            "wrist_roll": initial_obs[f"{prefix}_arm_wrist_roll.pos"],
            "gripper": initial_obs[f"{prefix}_arm_gripper.pos"],
        }
        # Set initial x/y to fixed values
        self.current_x = 0.1629
        self.current_y = 0.1131
        self.pitch = 0.0
        # Set the degree step and xy step
        self.degree_step = 2
        self.xy_step = 0.005
        # Set target positions to zero for P control
        self.target_positions = {
            "shoulder_pan": 0.0,
            "shoulder_lift": 0.0,
            "elbow_flex": 0.0,
            "wrist_flex": 0.0,
            "wrist_roll": 0.0,
            "gripper": 0.0,
        }
        self.zero_pos = {
            'shoulder_pan': 0.0,
            'shoulder_lift': 0.0,
            'elbow_flex': 0.0,
            'wrist_flex': 0.0,
            'wrist_roll': 0.0,
            'gripper': 0.0
        }

    def move_to_initial_position(self, robot, initial_obs):
        print(f"[{self.prefix}] Moving to Initial Position for safe exit...")
        self.target_positions = {
            "shoulder_pan": initial_obs[f"{self.prefix}_arm_shoulder_pan.pos"],
            "shoulder_lift": initial_obs[f"{self.prefix}_arm_shoulder_lift.pos"],
            "elbow_flex": initial_obs[f"{self.prefix}_arm_elbow_flex.pos"],
            "wrist_flex": initial_obs[f"{self.prefix}_arm_wrist_flex.pos"],
            "wrist_roll": initial_obs[f"{self.prefix}_arm_wrist_roll.pos"],
            "gripper": initial_obs[f"{self.prefix}_arm_gripper.pos"],
        }
        action = self.p_control_action(robot)
        robot.send_action(action)

    def move_to_zero_position(self, robot):
        print(f"[{self.prefix}] Moving to Zero Position: {self.zero_pos} ......")
        self.target_positions = self.zero_pos.copy()

        # Reset kinematic variables to their initial state
        self.current_x = 0.1629
        self.current_y = 0.1131
        self.pitch = 0.0

        # Don't let handle_keys recalculate wrist_flex - set it explicitly
        self.target_positions["wrist_flex"] = 0.0

        action = self.p_control_action(robot)
        robot.send_action(action)

    def handle_keys(self, key_state):
        # Joint increments
        if key_state.get('shoulder_pan+'):
            self.target_positions["shoulder_pan"] += self.degree_step
            print(f"[{self.prefix}] shoulder_pan: {self.target_positions['shoulder_pan']}")
        if key_state.get('shoulder_pan-'):
            self.target_positions["shoulder_pan"] -= self.degree_step
            print(f"[{self.prefix}] shoulder_pan: {self.target_positions['shoulder_pan']}")
        if key_state.get('wrist_roll+'):
            self.target_positions["wrist_roll"] += self.degree_step
            print(f"[{self.prefix}] wrist_roll: {self.target_positions['wrist_roll']}")
        if key_state.get('wrist_roll-'):
            self.target_positions["wrist_roll"] -= self.degree_step
            print(f"[{self.prefix}] wrist_roll: {self.target_positions['wrist_roll']}")

        # Gripper control: analog trigger maps proportionally (0=open/90deg, 1=closed/2deg)
        gripper_analog = key_state.get('gripper_analog', 0.0)
        gripper_pos = 90 - (gripper_analog * 88)
        self.target_positions["gripper"] = gripper_pos
        if gripper_analog > 0.05:
            print(f"[{self.prefix}] gripper: {gripper_pos:.1f} (trigger: {gripper_analog:.2f})")

        if key_state.get('pitch+'):
            self.pitch += self.degree_step
            print(f"[{self.prefix}] pitch: {self.pitch}")
        if key_state.get('pitch-'):
            self.pitch -= self.degree_step
            print(f"[{self.prefix}] pitch: {self.pitch}")

        # XY plane (IK)
        moved = False
        if key_state.get('x+'):
            self.current_x += self.xy_step
            moved = True
            print(f"[{self.prefix}] x+: {self.current_x:.4f}, y: {self.current_y:.4f}")
        if key_state.get('x-'):
            self.current_x -= self.xy_step
            moved = True
            print(f"[{self.prefix}] x-: {self.current_x:.4f}, y: {self.current_y:.4f}")
        if key_state.get('y+'):
            self.current_y += self.xy_step
            moved = True
            print(f"[{self.prefix}] x: {self.current_x:.4f}, y+: {self.current_y:.4f}")
        if key_state.get('y-'):
            self.current_y -= self.xy_step
            moved = True
            print(f"[{self.prefix}] x: {self.current_x:.4f}, y-: {self.current_y:.4f}")
        if moved:
            joint2, joint3 = self.kinematics.inverse_kinematics(self.current_x, self.current_y)
            self.target_positions["shoulder_lift"] = joint2
            self.target_positions["elbow_flex"] = joint3
            print(f"[{self.prefix}] shoulder_lift: {joint2}, elbow_flex: {joint3}")

        # Wrist flex is always coupled to pitch and the other two
        self.target_positions["wrist_flex"] = (
            -self.target_positions["shoulder_lift"]
            -self.target_positions["elbow_flex"]
            + self.pitch
        )

    def p_control_action(self, robot):
        obs = robot.get_observation()
        current = {j: obs[f"{self.prefix}_arm_{j}.pos"] for j in self.joint_map}
        action = {}
        for j in self.target_positions:
            error = self.target_positions[j] - current[j]
            control = self.kp * error
            action[f"{self.joint_map[j]}.pos"] = current[j] + control
        return action


# --- XBOX Controller Mapping ---
def get_xbox_key_state(joystick, keymap):
    """
    Map XBOX controller state to semantic action booleans using the provided keymap.
    """
    # Read axes, buttons, hats
    axes = [joystick.get_axis(i) for i in range(joystick.get_numaxes())]
    buttons = [joystick.get_button(i) for i in range(joystick.get_numbuttons())]
    hats = joystick.get_hat(0) if joystick.get_numhats() > 0 else (0, 0)

    # Get stick pressed states
    left_stick_pressed = bool(buttons[11]) if len(buttons) > 11 else False
    right_stick_pressed = bool(buttons[12]) if len(buttons) > 12 else False
    lb_pressed = bool(buttons[4]) if len(buttons) > 4 else False
    rb_pressed = bool(buttons[5]) if len(buttons) > 5 else False

    # Map controller state to semantic actions
    state = {}
    for action, control in keymap.items():
        if control == 'left_trigger':
            state[action] = axes[2] > 0.5 if len(axes) > 2 else False
            # Also expose analog value: normalize from -1..1 to 0..1
            state['gripper_analog'] = (axes[2] + 1) / 2 if len(axes) > 2 else 0.0
        elif control == 'right_trigger':
            state[action] = axes[5] > 0.5 if len(axes) > 5 else False
            # Also expose analog value: normalize from -1..1 to 0..1
            state['gripper_analog'] = (axes[5] + 1) / 2 if len(axes) > 5 else 0.0
        elif control == 'a':
            state[action] = bool(buttons[0])
        elif control == 'b':
            state[action] = bool(buttons[1])
        elif control == 'x':
            state[action] = bool(buttons[2])
        elif control == 'y':
            state[action] = bool(buttons[3])
        elif control == 'back':
            state[action] = bool(buttons[8])
        elif control == 'dpad_up':
            state[action] = hats[1] == 1
        elif control == 'dpad_down':
            state[action] = hats[1] == -1
        elif control == 'dpad_left':
            state[action] = hats[0] == -1
        elif control == 'dpad_right':
            state[action] = hats[0] == 1
        # Left stick controls (when not pressed)
        elif control == 'left_stick_up':
            state[action] = (not left_stick_pressed) and (not lb_pressed) and (axes[1] < -0.5) if len(axes) > 1 else False
        elif control == 'left_stick_down':
            state[action] = (not left_stick_pressed) and (not lb_pressed) and (axes[1] > 0.5) if len(axes) > 1 else False
        elif control == 'left_stick_left':
            state[action] = (not left_stick_pressed) and (not lb_pressed) and (axes[0] < -0.5) if len(axes) > 0 else False
        elif control == 'left_stick_right':
            state[action] = (not left_stick_pressed) and (not lb_pressed) and (axes[0] > 0.5) if len(axes) > 0 else False
        # Right stick controls (when not pressed)
        elif control == 'right_stick_up':
            state[action] = (not right_stick_pressed) and (not rb_pressed) and (axes[4] < -0.5) if len(axes) > 4 else False
        elif control == 'right_stick_down':
            state[action] = (not right_stick_pressed) and (not rb_pressed) and (axes[4] > 0.5) if len(axes) > 4 else False
        elif control == 'right_stick_left':
            state[action] = (not right_stick_pressed) and (not rb_pressed) and (axes[3] < -0.5) if len(axes) > 3 else False
        elif control == 'right_stick_right':
            state[action] = (not right_stick_pressed) and (not rb_pressed) and (axes[3] > 0.5) if len(axes) > 3 else False
        # Left stick pressed controls
        elif control == 'left_stick_pressed_right':
            state[action] = left_stick_pressed and (not lb_pressed) and (axes[0] > 0.5) if len(axes) > 0 else False
        elif control == 'left_stick_pressed_left':
            state[action] = left_stick_pressed and (not lb_pressed) and (axes[0] < -0.5) if len(axes) > 0 else False
        # Right stick pressed controls
        elif control == 'right_stick_pressed_right':
            state[action] = right_stick_pressed and (not rb_pressed) and (axes[3] > 0.5) if len(axes) > 3 else False
        elif control == 'right_stick_pressed_left':
            state[action] = right_stick_pressed and (not rb_pressed) and (axes[3] < -0.5) if len(axes) > 3 else False
        # LB pressed controls (only when stick is moved)
        elif control == 'lb_up':
            state[action] = lb_pressed and (abs(axes[1]) > 0.5) and (axes[1] < -0.5) if len(axes) > 1 else False
        elif control == 'lb_down':
            state[action] = lb_pressed and (abs(axes[1]) > 0.5) and (axes[1] > 0.5) if len(axes) > 1 else False
        elif control == 'lb_right':
            state[action] = lb_pressed and (abs(axes[0]) > 0.5) and (axes[0] > 0.5) if len(axes) > 0 else False
        elif control == 'lb_left':
            state[action] = lb_pressed and (abs(axes[0]) > 0.5) and (axes[0] < -0.5) if len(axes) > 0 else False
        # RB pressed controls (only when stick is moved)
        elif control == 'rb_up':
            state[action] = rb_pressed and (abs(axes[4]) > 0.5) and (axes[4] < -0.5) if len(axes) > 4 else False
        elif control == 'rb_down':
            state[action] = rb_pressed and (abs(axes[4]) > 0.5) and (axes[4] > 0.5) if len(axes) > 4 else False
        elif control == 'rb_right':
            state[action] = rb_pressed and (abs(axes[3]) > 0.5) and (axes[3] > 0.5) if len(axes) > 3 else False
        elif control == 'rb_left':
            state[action] = rb_pressed and (abs(axes[3]) > 0.5) and (axes[3] < -0.5) if len(axes) > 3 else False
        else:
            state[action] = False
    return state

def get_base_action(joystick, robot):
    """
    Get base action from XBOX controller input - simplified to only forward/backward and rotate.
    """
    # Read controller state
    buttons = [joystick.get_button(i) for i in range(joystick.get_numbuttons())]
    hats = joystick.get_hat(0) if joystick.get_numhats() > 0 else (0, 0)

    # Get pressed keys for base control
    pressed_keys = set()

    # Map controller inputs to keyboard-like keys for base control
    if hats[1] == 1:   # D-pad up
        pressed_keys.add('i')  # Forward
    if hats[1] == -1:  # D-pad down
        pressed_keys.add('k')  # Backward
    if hats[0] == -1:  # D-pad left
        pressed_keys.add('u')  # Rotate left
    if hats[0] == 1:   # D-pad right
        pressed_keys.add('o')  # Rotate right

    # Convert to numpy array and get base action
    keyboard_keys = np.array(list(pressed_keys))
    base_action = robot._from_keyboard_to_base_action(keyboard_keys) or {}

    return base_action

def get_base_speed_control(joystick):
    """
    Get base speed control from XBOX controller - LB for speed decrease, RB for speed increase.
    Returns speed multiplier (1.0, 2.0, or 3.0) and prints current speed level.
    """
    # Read controller state
    buttons = [joystick.get_button(i) for i in range(joystick.get_numbuttons())]

    # Get LB and RB states
    lb_pressed = bool(buttons[4]) if len(buttons) > 4 else False
    rb_pressed = bool(buttons[5]) if len(buttons) > 5 else False

    # Get current speed level from global variable
    global current_base_speed_level
    if 'current_base_speed_level' not in globals():
        current_base_speed_level = 1  # Default speed level

    # Speed control logic
    if lb_pressed and not rb_pressed:
        # LB pressed alone - decrease speed
        if current_base_speed_level > 1:
            current_base_speed_level -= 1
            print(f"[BASE] Speed decreased to level {current_base_speed_level}")
    elif rb_pressed and not lb_pressed:
        # RB pressed alone - increase speed
        if current_base_speed_level < 3:
            current_base_speed_level += 1
            print(f"[BASE] Speed increased to level {current_base_speed_level}")

    # Map speed level to multiplier
    speed_multiplier = float(current_base_speed_level)

    return speed_multiplier



def main():
    FPS = 30
    robot_config = XLerobotNewWiringConfig()
    robot = XLerobotNewWiring(robot_config)
    try:
        robot.connect()
        print(f"[MAIN] Successfully connected to robot")
    except Exception as e:
        print(f"[MAIN] Failed to connect to robot: {e}")
        print(robot_config)
        print(robot)
        return

    init_rerun(session_name="xlerobot_teleop_xbox_new_wiring")

    # Init XBOX controller
    pygame.init()
    pygame.joystick.init()
    if pygame.joystick.get_count() == 0:
        print("No XBOX controller detected!")
        return
    joystick = pygame.joystick.Joystick(0)
    joystick.init()
    print(f"[MAIN] Using controller: {joystick.get_name()}")
    pygame.event.pump()
    num_axes = joystick.get_numaxes()
    num_buttons = joystick.get_numbuttons()
    print(f"[MAIN] Controller axes: {num_axes}, buttons: {num_buttons}")
    print(f"[MAIN] Axis values at rest: {[round(joystick.get_axis(i), 3) for i in range(num_axes)]}")
    print(f"[MAIN] Button states at rest: {[joystick.get_button(i) for i in range(num_buttons)]}")
    print(f"[MAIN] NOTE: left trigger expected on axis 2, right trigger on axis 5 (resting = -1.0)")

    # Init the arm and head instances
    obs = robot.get_observation()
    initial_obs = obs.copy()
    kin_left = SO101Kinematics()
    kin_right = SO101Kinematics()
    left_arm = SimpleTeleopArm(kin_left, LEFT_JOINT_MAP, obs, prefix="left")
    right_arm = SimpleTeleopArm(kin_right, RIGHT_JOINT_MAP, obs, prefix="right")
    head_control = SimpleHeadControl(obs)

    # Move both arms and head to zero position at start
    left_arm.move_to_zero_position(robot)
    right_arm.move_to_zero_position(robot)

    try:
        while True:
            pygame.event.pump()
            left_key_state = get_xbox_key_state(joystick, LEFT_KEYMAP)
            right_key_state = get_xbox_key_state(joystick, RIGHT_KEYMAP)

            # Check for global reset (back button)
            buttons = [joystick.get_button(i) for i in range(joystick.get_numbuttons())]
            global_reset = bool(buttons[8]) if len(buttons) > 8 else False

            # Handle global reset for all components
            if global_reset:
                print("[MAIN] Global reset triggered!")
                left_arm.move_to_initial_position(robot, initial_obs)
                right_arm.move_to_initial_position(robot, initial_obs)
                head_control.move_to_initial_position(robot, initial_obs)
                continue

            # Check for exit (start button)
            start_pressed = bool(buttons[9]) if len(buttons) > 9 else False
            if start_pressed:
                print("[MAIN] Safe exit triggered! Returning to initial position...")
                left_arm.move_to_initial_position(robot, initial_obs)
                right_arm.move_to_initial_position(robot, initial_obs)
                head_control.move_to_initial_position(robot, initial_obs)
                time.sleep(2)  # Give time for arms to reach initial position
                break

            # Handle both arms separately and simultaneously
            left_arm.handle_keys(left_key_state)
            right_arm.handle_keys(right_key_state)
            head_control.handle_keys(left_key_state)  # Head controlled by left arm keymap

            left_action = left_arm.p_control_action(robot)
            right_action = right_arm.p_control_action(robot)
            head_action = head_control.p_control_action(robot)

            # Get base action and speed control from controller
            base_action = get_base_action(joystick, robot)
            speed_multiplier = get_base_speed_control(joystick)

            # Apply speed multiplier to base actions if they exist
            if base_action:
                for key in base_action:
                    if 'vel' in key or 'velocity' in key:  # Apply to velocity commands
                        base_action[key] *= speed_multiplier

            # Merge all actions
            action = {**left_action, **right_action, **head_action, **base_action}
            robot.send_action(action)

            obs = robot.get_observation()
            log_rerun_data(obs, action)
    finally:
        robot.disconnect()
        print("Teleoperation ended.")

if __name__ == "__main__":
    main()
