Minko82/xlerobot-pro/(commit log)

2026-01-30 add teleoperation and else
    [precision_test_results.csv]
2026-01-30 Update calibration file paths in README
2026-01-30 Update README with important note on port permissions
    Clarify the importance of rerunning the permission command after replugging cables.
2026-02-09 get head motor data for transform
    [vision.ply]
2026-02-11 store SO100 stl assets in lfs
    [Gauge_0.STL, Gauge_tight_1.STL, Lego_Size_Test_02_minuspoint1.STL, Lego_Size_Test_02_zero.STL, Mini_SO_100_01g.STL, Print_Follower_SO_ARM100_08k_UP_BambuLabA1Mini_part1.STL, Print_Follower_SO_ARM100_08k_UP_BambuLabA1Mini_part2.STL, Print_Follower_SO_ARM100_08k_UP_Prusa - Base_08q-3.STL]
2026-02-11 update project.toml with new power test script
2026-02-11 create xlerobot_power_experiments script for testing power draw with various motor configurations
2026-02-13 adding urdf file
    [so101_new_calib.urdf]
2026-02-13 fixed segfaults on vision and ik
    [vision.ply]
2026-02-13 calibrating vision and ik
2026-02-21 added motor id script
2026-02-21 frame transform no longer crashes with certain numpy versions
    [control.py, point_cloud.py, so101-drop_pen.py, so101-grab-apple.py, so101-hang.py, so101-pen.py]
2026-02-22 added head calibration, fixed urdf mismatch
    [control.py, debug_frames.py, point_cloud.py]
2026-02-27 updating to move to nano
    [Fixed_Jaw_part1.ply, Fixed_Jaw_part2.ply, Moving_Jaw_part1.ply, Moving_Jaw_part2.ply, Moving_Jaw_part3.ply]
2026-02-28 add new wiring design for xbox teleop and robot class
    - Label old wiring (left arm+head on bus1, right arm+wheels on bus2)
    - Add XLerobotNewWiringConfig and XLerobotNewWiring for new wiring
    (both arms on bus1 IDs 1-12, head+wheels on bus2 IDs 1-5)
    - Add 5_xlerobot_teleop_xbox_new_wiring.py with sys.path injection
    so it resolves lerobot from xle-robot/src without PYTHONPATH
    [5_xlerobot_teleop_xbox_new_wiring.py, config_xlerobot.py, xlerobot_new_wiring.py]
2026-02-28 new urdf xml integrated into control and ik
    [Fixed_Jaw_part1.ply, Fixed_Jaw_part2.ply, Moving_Jaw_part1.ply, Moving_Jaw_part2.ply, Moving_Jaw_part3.ply]
2026-03-01 working vision ik, arm position is swapped
2026-03-01 added diagnose script for checking error
    [diagnose.py]
2026-04-09 refining stubbed capabilities to be more applicable to use case
2026-04-14 adjustments to wire in yolo model and both yolo/vlm observation methods
2026-04-24 refactoring camera setups to allow zmq server for multiple consumers, catching camera read errors for dataset recording handling, using new zmq server
2026-10-11 Share one capture directory between RealSense and color detection; report unreachable IK targets
    The capture writer used a path relative to the working directory and the
    reader one relative to the package, so runs started anywhere else read
    stale or missing frames. Both now use config.CAPTURE_DIR.
    An unreachable IK target could leave the trajectory empty and raise
    IndexError; it is now reported as non-convergence.
2026-10-11 Pin the vision stack to the versions installed on the robot
    Pink 4.3.0 is the version cited in the paper. pin 3.4.0 is built against
    urdfdom 4 and fails to import with the urdfdom 6 that pip now resolves, so
    pin cmeel-urdfdom 4.0.1 and cmeel-tinyxml2 10.0.0 as on the Jetson.
2026-10-11 Bring docs and comments in line with the paper
    firmware_limits: use the paper's bus names (Bus 1 arms, Bus 2 head and
    wheels), cite Eq. (1) and its 4.43 A estimate against a 5 A design budget,
    and drop the fuse and 1 kg payload wording. Values are unchanged.
    Policy scripts: describe act_policy_control.py as the runner behind the
    paper's grasping test with its exact settings, and say plainly that the
    SmolVLA script replays a dataset and the diffusion script is a toy model.
    Examples and vision READMEs: drop Tri-Bus, flag that grab_cube.py still
    uses the single-bus motor map, and point the scripted demos at the
    repo-root calibration file they could not find.
2026-10-11 Add what the paper's experiments need to run from this repo
    - scripts/calibrate_xlerobot.py: whole-robot calibration, since
    lerobot-calibrate cannot load this robot
    - scripts/xle_arms.py: drive either arm on the shared arms bus; the ACT
    runner needed it from the data repo before
    - calibration/hand_mask_grey88.png: the mask used for the grasping policy
    - benchmarks/: the SmolVLA and Diffusion Policy timing scripts behind the
    paper's tables, unchanged from the robot
    - hardware/README.md: the tested print settings, which the 3MF does not
    apply by default
2026-10-11 Rewrite the README around the paper
    What changed from XLeRobot and why, measured results with their
    conditions, the parts list, print settings, power layout and motor IDs,
    setup from a fresh Jetson, and the record, train, and run loop with the
    settings from the paper.
2026-10-11 Apply High-Shell in the 3MF and add the Jetson frame and arm-base CAD
    The 18 SO-101 arm parts now carry 4 perimeters (15% infill) as per-object
    settings, named '(arm, High-Shell)'. Mesh data and the global profile are
    unchanged. Also add the Jetson mounting frame (STL) and the arm base (STEP)
    from the project website.
2026-10-12 Match the docs to the final paper
    Describe XLeRobot's original two-bus wiring correctly, note the likely
    pass-through charging on the 0.7 kg hold, add the projected battery
    runtime and the teleoperation objects, state the cost of 2-step SmolVLA,
    and use the paper's current-estimate wording.
2026-10-12 Use the paper's wording for the supply collapse and the Jetson enclosure
2026-10-12 State that every hold ran on battery
2026-10-12 Make the Quality checks pass again
    - Format the benchmark scripts and the files merged in from main with
    ruff, and the README tables with prettier
    - Keep the whitespace and spelling hooks off STL and STEP exports, which
    must stay exactly as the CAD tool wrote them
    - Mark the two intended bandit findings: the best-effort disconnect in
    the power experiments, and a string comparison with 0.0.0.0 in the VR
    monitor
    - Stop routing *.stl through Git LFS: the meshes are committed as regular
    files, so with git-lfs installed every STL showed up as modified
2026-10-13 Host the README photo in the repo and clear the 3MF title
    The README photo was a GitHub user-attachments link, which resolves to the
    uploading account. It now lives in docs/images (metadata stripped). The 3MF
    title and description fields are blank; the geometry and slicer settings are
    unchanged.
2026-10-26 Call the Jetson part an open frame and link the wrist-camera mount
    The Jetson open frame is nvidia-jetson-mounting-frame.stl, a separate
    download; the docs said it was inside the 3MF, which it is not. The
    optional wrist cameras use the SO-101 Hex-Nut wrist-camera mount from
    SO-ARM100, the same one XLeRobot uses, so hardware/README.md now links it.
2026-10-27 Put the Jetson open frame in the 3MF
    The print project now holds every printed part: the Jetson open frame sits
    on its own seventh bed with the default profile, so one download covers the
    whole build. The other 60 parts, their High-Shell settings, and the blank
    title and description fields are unchanged. The frame STL stays for other
    slicers.
2026-10-31 Add XLeRobot SLAM and Nav2 navigation stack
    RTAB-Map mapping/localization with a RealSense depth camera, Nav2
    (MPPI + Smac Hybrid) config, and /cmd_vel bridges to the omniwheel base.
    Ported from fast_lio_nav2_humanoid with launch defaults resolved via the
    package share directory instead of hardcoded home paths.
2026-10-31 Set Nav2 footprint to the XLeRobot cart size
    Replace the 5 cm placeholder with a 0.46 m square covering the RASKOG
    cart base tier (0.391 x 0.459 m) and raise inflation_radius to stay
    above the circumscribed radius.
